andrewjacon15-ui/agriculture-sprayer-test-rig/docs/08_Component_Reference/README.md

# 08 -- Component Reference

One page per major hardware component, written so that someone with none of
this project's history could pick up the rig, understand what each part
does and how it's wired, and repair or rebuild it from scratch.

Each page summarizes the specs that actually matter for this build (in
plain language) and links to the manufacturer's own official documentation
for anything more detailed (full mechanical drawings, absolute maximum
ratings, etc.) rather than reproducing entire datasheets here. Manufacturer
documentation is the authoritative source if anything here ever seems to
disagree with the part in your hand -- component revisions and minor spec
changes happen, so verify against the current official datasheet before a
rebuild, especially for anything dimensional (hole spacing, shaft
diameter).

- [Pololu 37D Metal Gearmotor (19:1, with encoder)](Pololu_37D_Gearmotor.md)
- [Cytron MD13S Motor Driver](Cytron_MD13S_Driver.md)
- [Omron V-156 Limit Switch](Omron_V156_Limit_Switch.md)
- [Arduino Uno Rev3](Arduino_Uno_R3.md)
- [Mean Well LRS-150-12 Power Supply](MeanWell_LRS-150-12.md)
