andrewjacon15-ui/agriculture-sprayer-test-rig/(commit log)

2026-09-25 Add sprayer carriage speed-test rig: BOM, assembly/wiring docs, Arduino firmware
    Belt-driven carriage on V-slot rail (6 ft measured zone + 12 in accel/decel
    buffers each end), Pololu 19:1 gearmotor with encoder, Cytron MD13S driver,
    Arduino Uno control with limit-switch homing and optional closed-loop PI
    speed control. Full BOM (~$455, under $1,500 budget), assembly/wiring/
    calibration/troubleshooting/safety docs, and per-component datasheet
    reference sheets.
2026-09-25 Add visual rail layout drawing (plan view + control block diagram)
    HTML/SVG version of the mechanical plan view and control system block
    diagram, for reference alongside the ASCII diagrams in the docs.
2026-09-25 Add beginner setup guide (00_Start_Here.md) and static drawing image
    - New doc: complete tool list (mechanical + electrical), step-by-step
    Arduino IDE install for Windows/Mac, recommended build order checklist,
    and a plain-English glossary -- written for someone with no prior
    electronics/software experience.
    - Embed the rail layout drawing as a PNG in docs/images/ so it renders
    directly on GitHub/README without opening the interactive HTML version.
    - Fix inconsistency: assembly doc listed a soldering iron as required;
    the design is actually screw-terminal only. Corrected and cross-linked
    to the new beginner guide.
